doppelgrau/AGO_PoE-Switch/README.md

# AGO_PoE-Switch

A simple ethernet switch, four ports with passive PoE, one without.
Input protected against reverse polarity and over voltage (>15V)
