doppelgrau/AGO_PoE-Switch/Case/stl/Power-Case_Bottom.stl

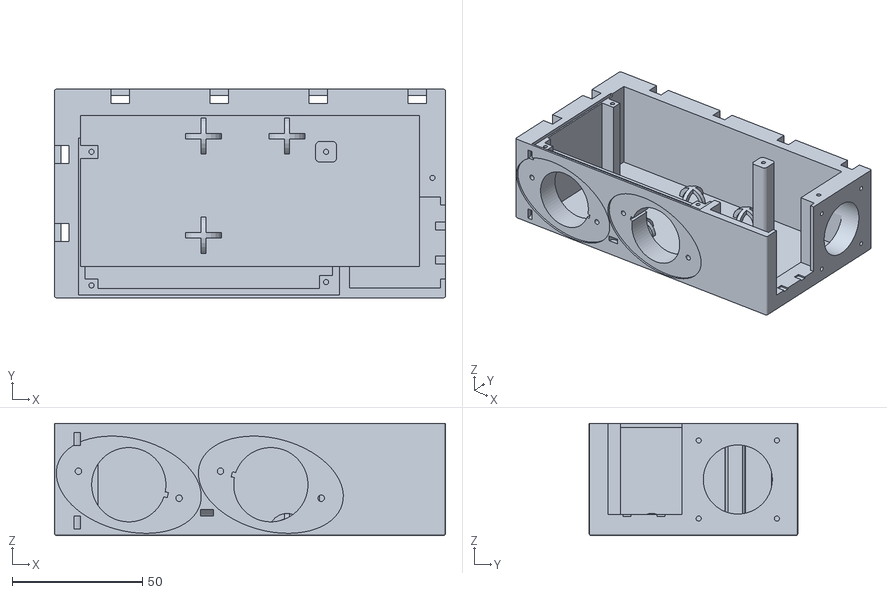
[picture p1: CAD file, 2021-09-09]
Case/stl/Power-Case_Bottom.stl
150.0 x 80.0 x 43.0
