doppelgrau/AGO_PoE-Switch/Case/stl/Power-Case_Top_Transparent.stl

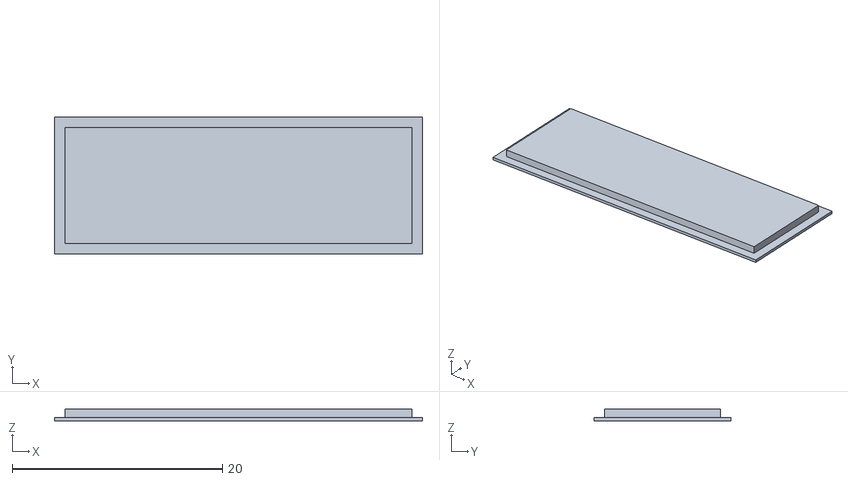
[picture p2: CAD file, 2021-09-09]
Case/stl/Power-Case_Top_Transparent.stl
35.0 x 13.0 x 1.10
