doppelgrau/AGO_PoE-Switch/PCB/Platine-PoE-Switch.pdf

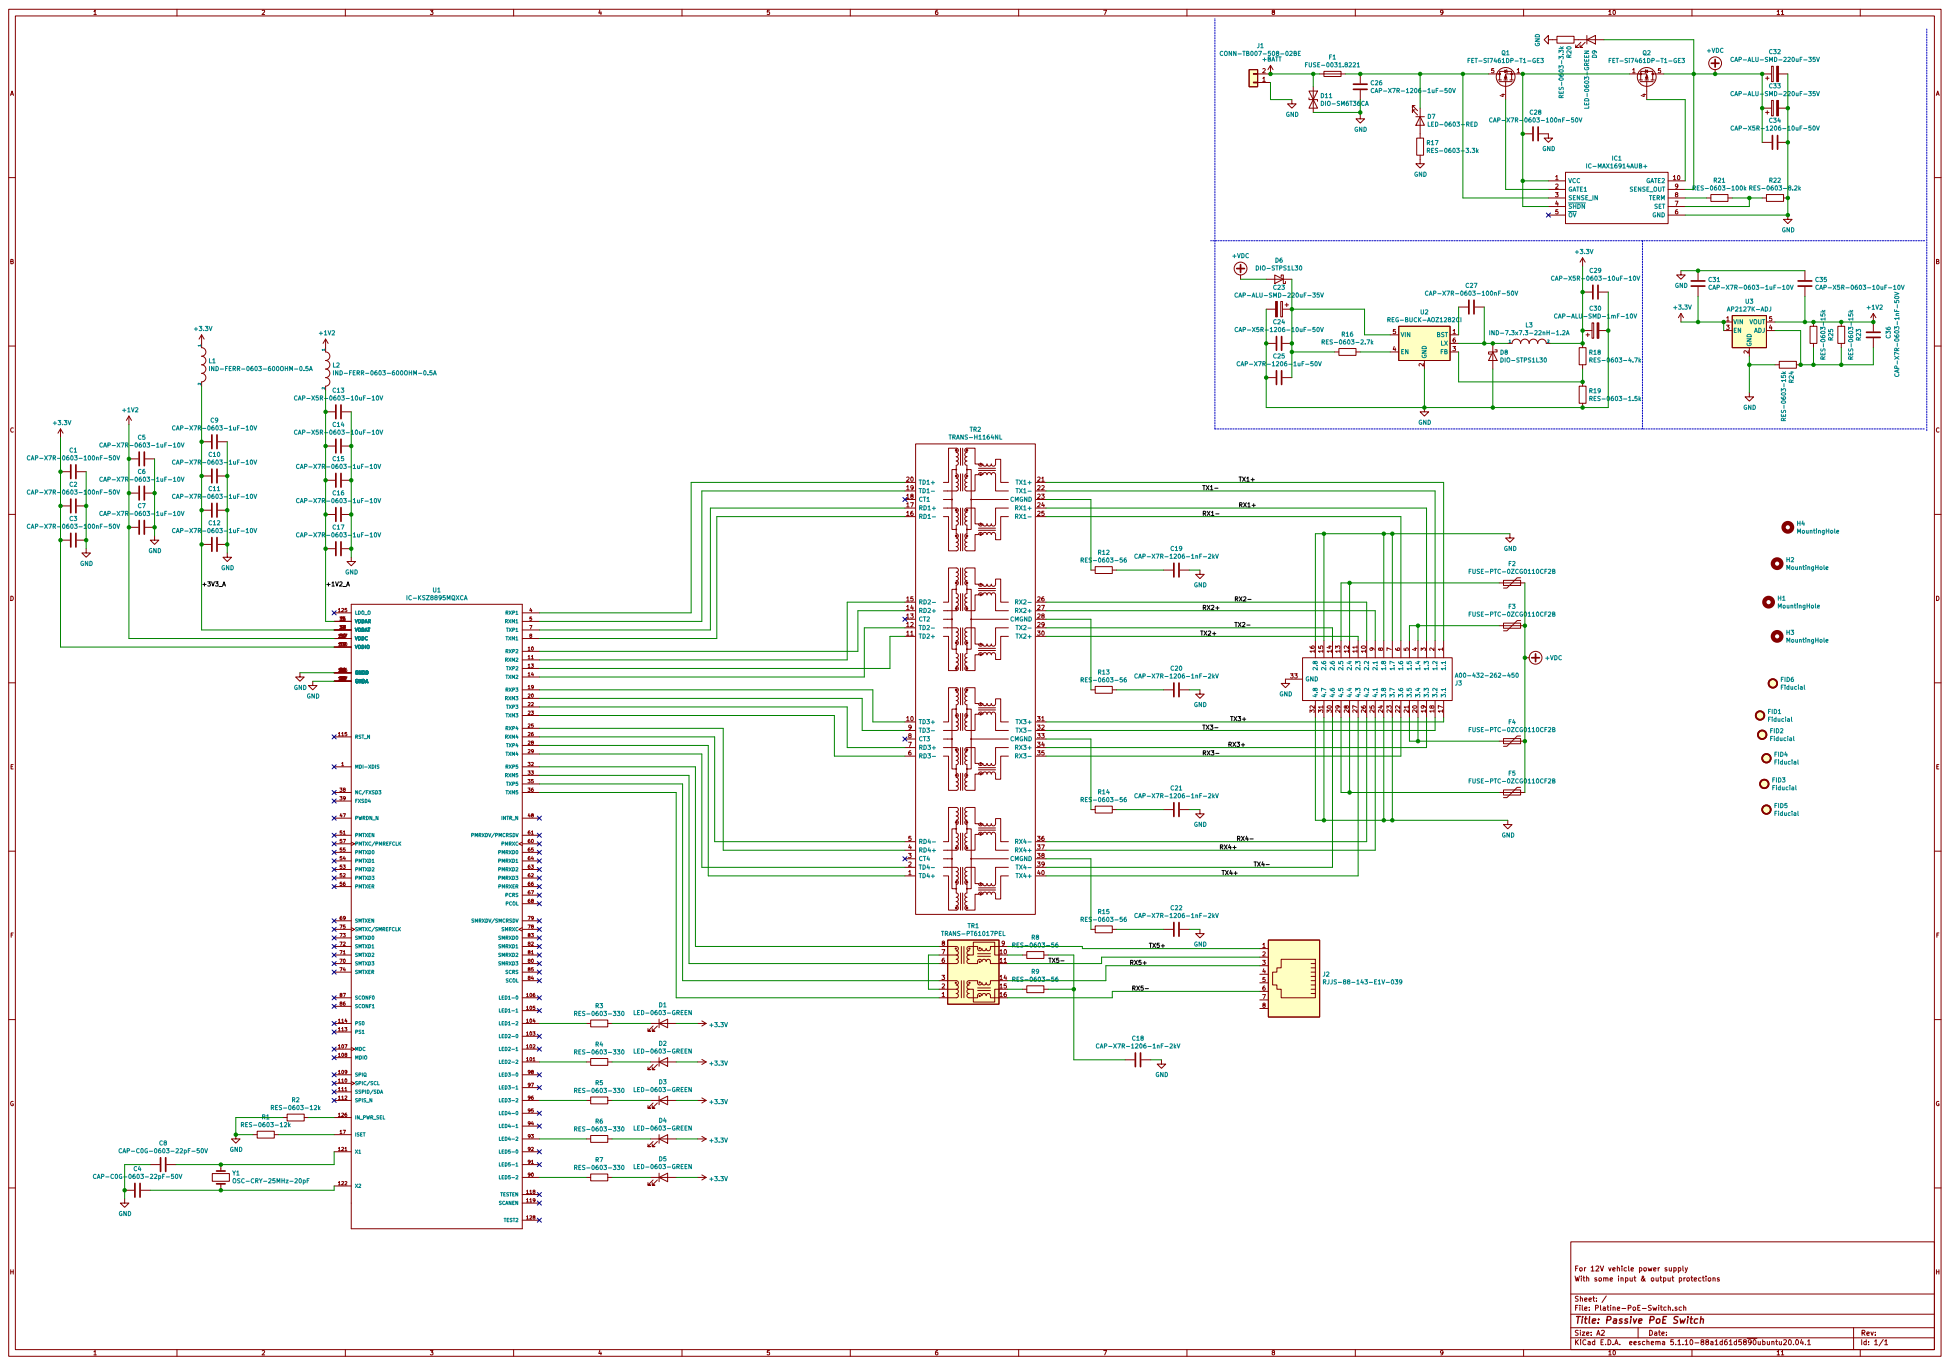
[picture p3: page 1]

IND-FERR-0603-600OHM-0.5A C9 CAP-X7R-0603-1uF-10V C10 CAP-X7R-0603-1uF-10V C11 CAP-X7R-0603-1uF-10V C12 CAP-X7R-0603-1uF-10V GND

C1 CAP-X7R-0603-100nF-50V C2 CAP-X7R-0603-100nF-50V C3 CAP-X7R-0603-100nF-50V GND

For 12V vehicle power supply R1 RES-0603-12k

File: Platine-PoE-Switch.sch Sheet: / With some input & output protections

Id: 1/1 Title: Passive PoE Switch
