doppelgrau/AGO_PoE-Switch/PCB/Platine-PoE-Switch.kicad_pcb

## KiCad design PCB/Platine-PoE-Switch.kicad_pcb (2021-09-09)

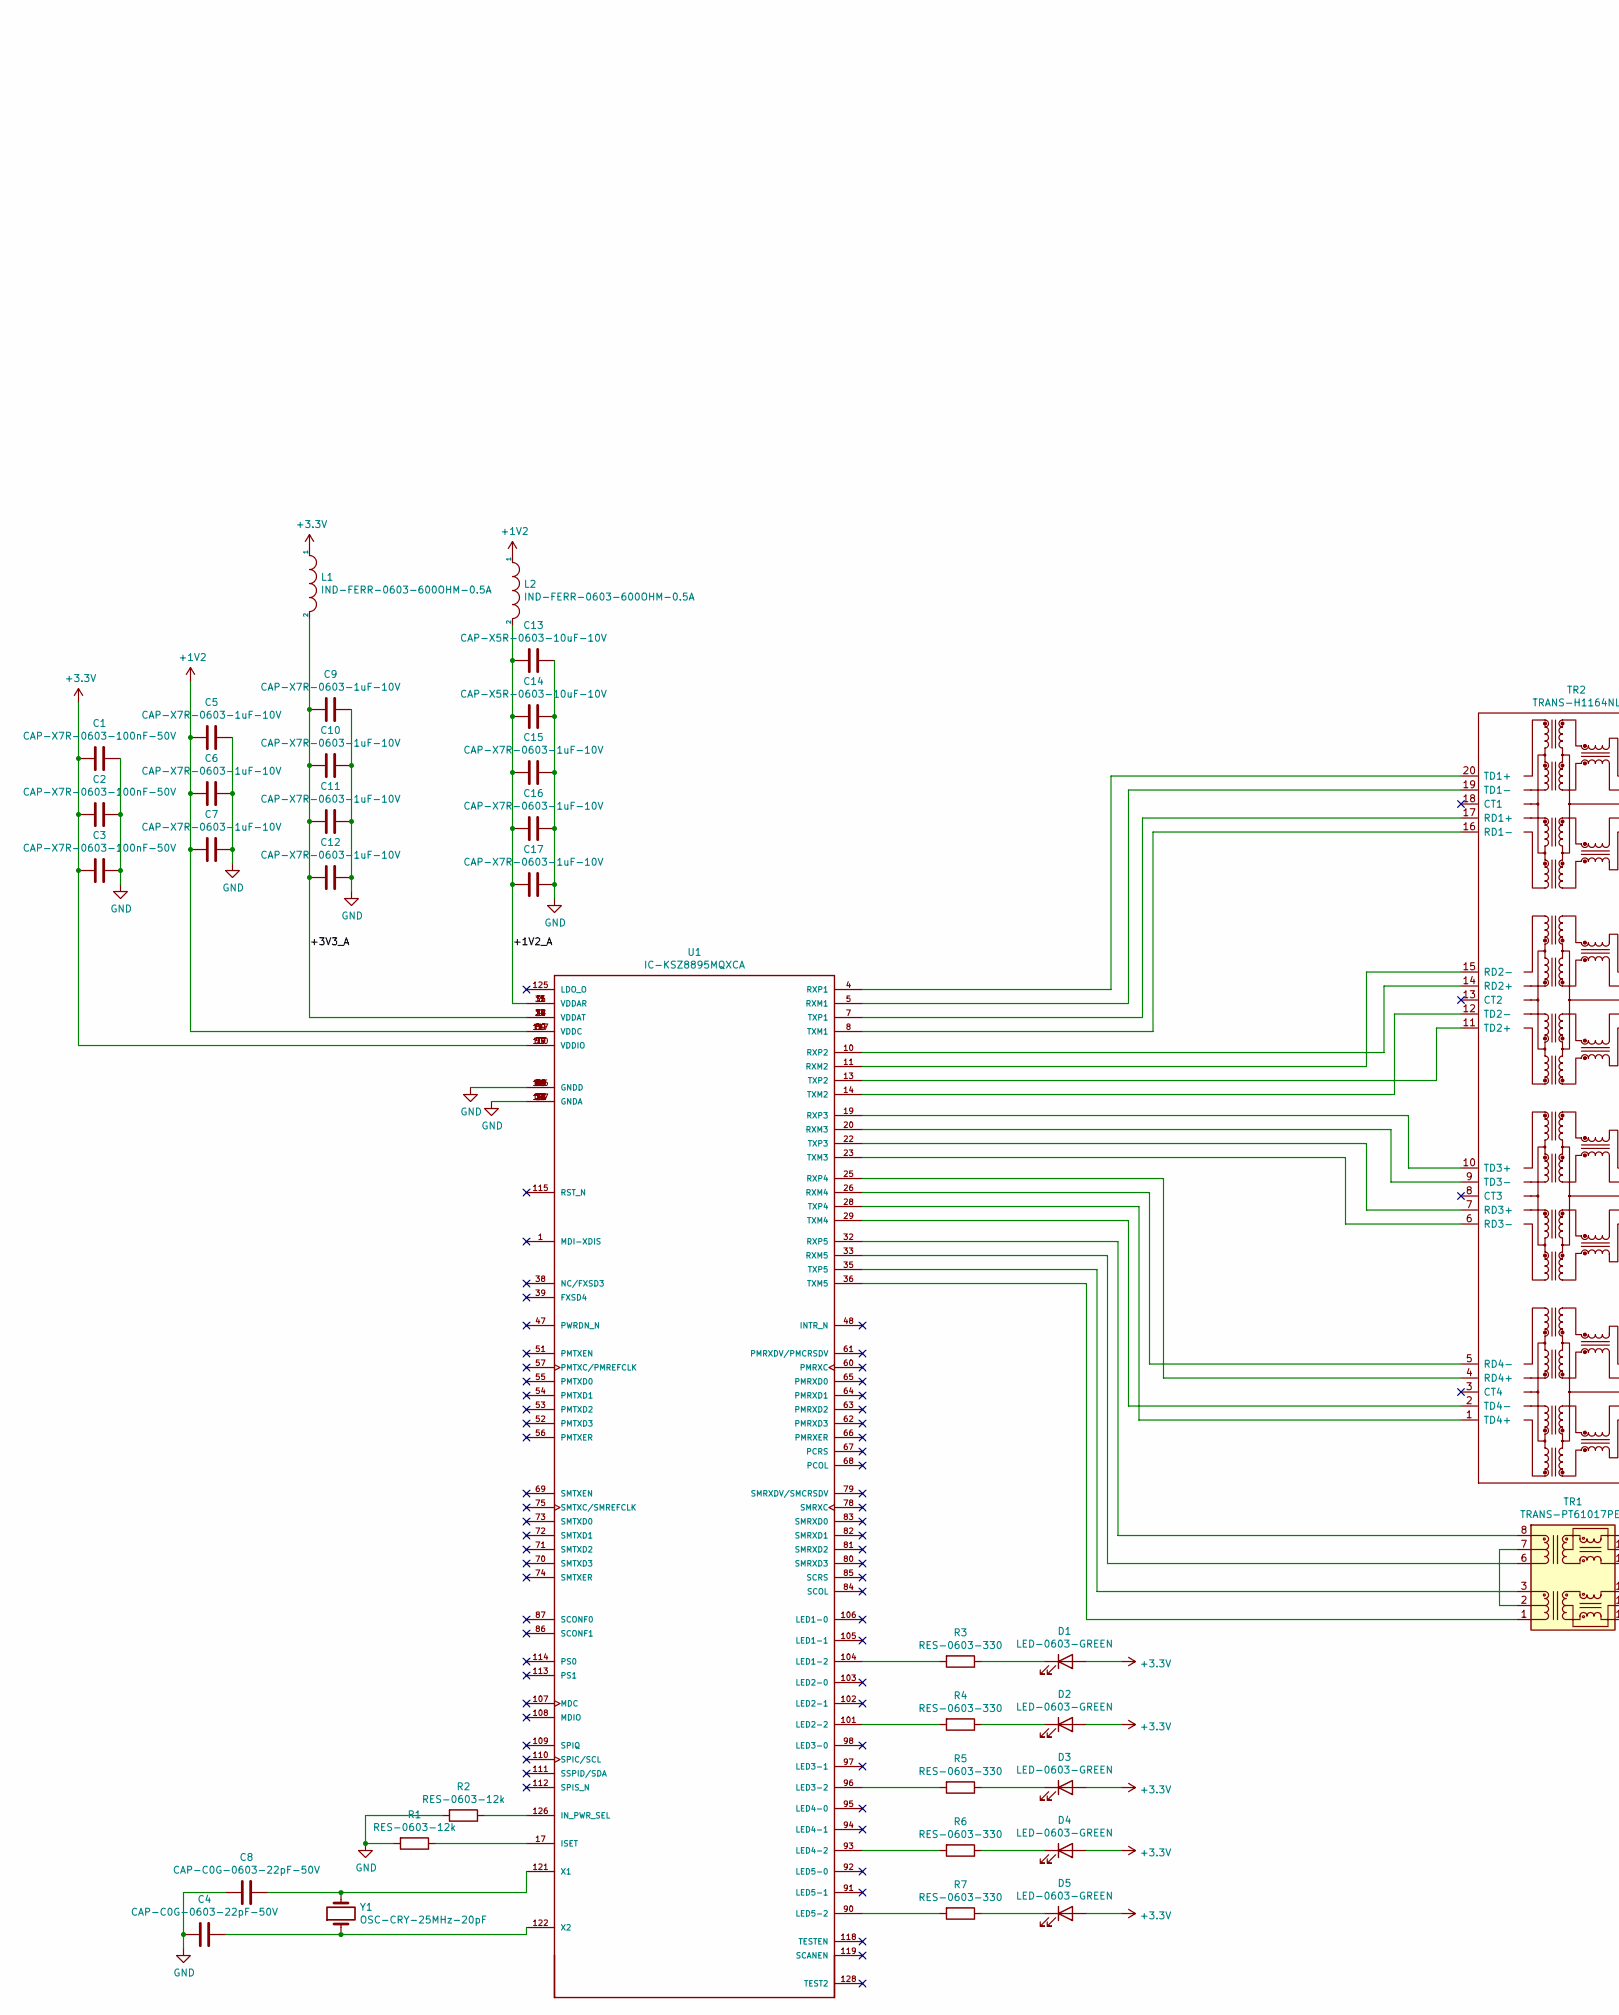
[picture p4: schematic Platine-PoE-Switch.sch, Passive PoE Switch, part in row 1, column 1]

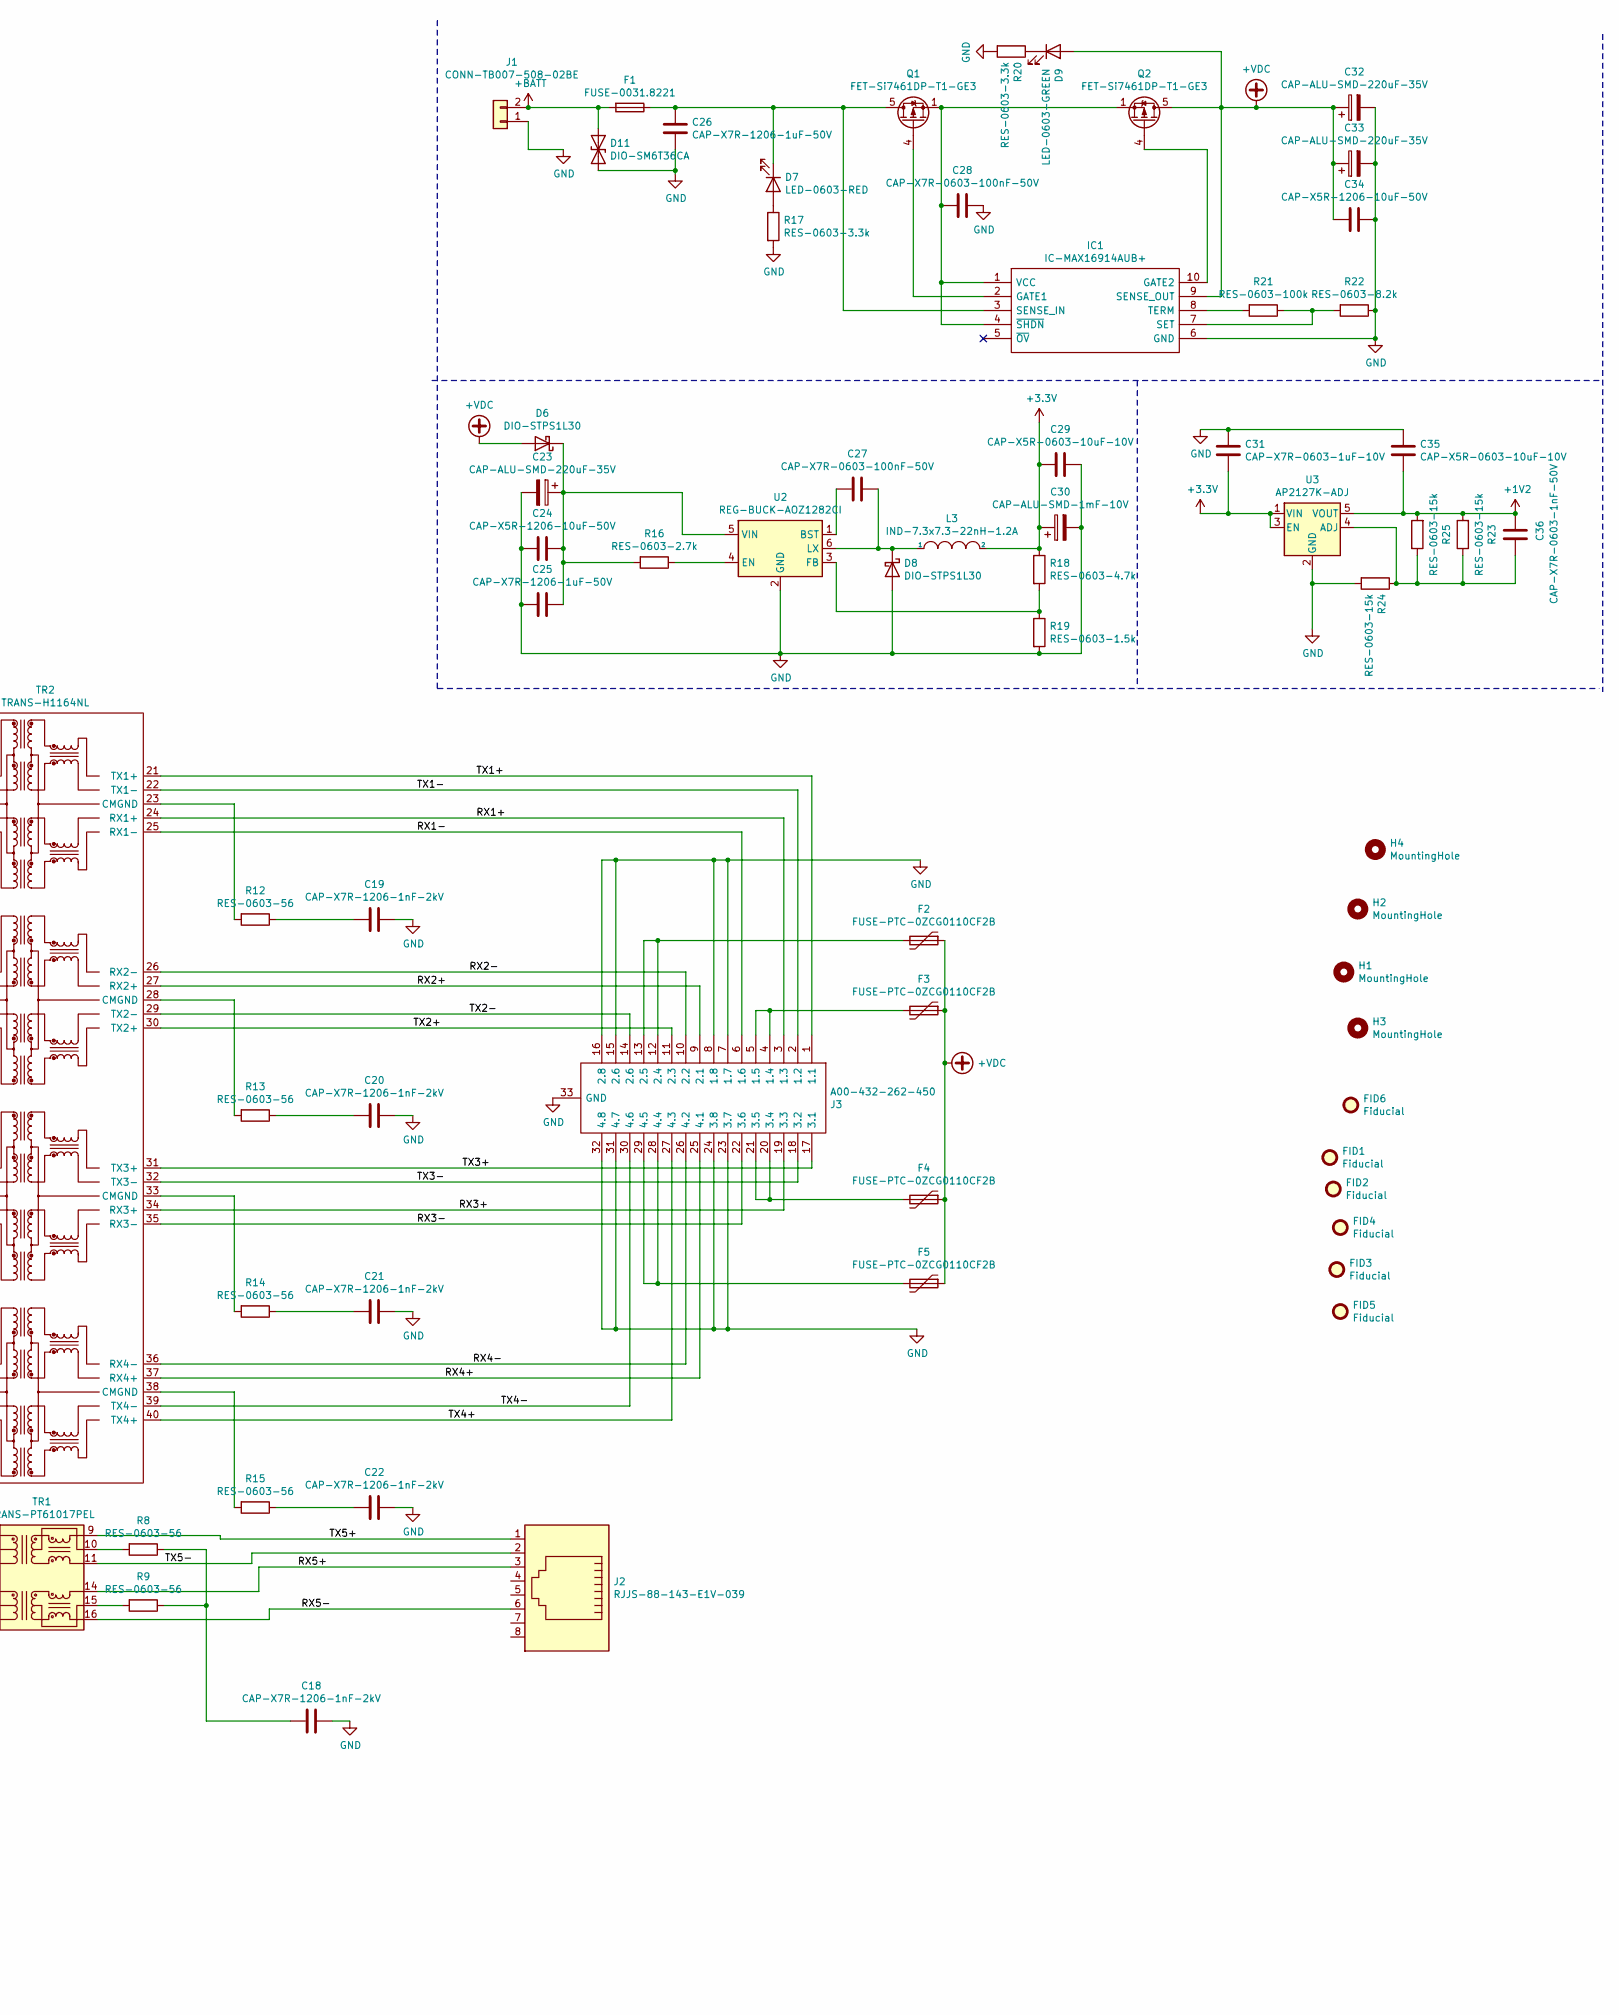
[picture p5: schematic Platine-PoE-Switch.sch, Passive PoE Switch, part in row 1, column 2]

Parts:
C1, C2, C3, C27, C28: CAP-X7R-0603-100nF-50V; C_0603_1608Metric
C4, C8: CAP-C0G-0603-22pF-50V; C_0603_1608Metric
C5, C6, C7, C9, C10, C11, C12, C15, C16, C17, C31: CAP-X7R-0603-1uF-10V; C_0603_1608Metric
C13, C14, C29, C35: CAP-X5R-0603-10uF-10V; C_0603_1608Metric
C18, C19, C20, C21, C22: CAP-X7R-1206-1nF-2kV; C_1206_3216Metric
C23, C32, C33: CAP-ALU-SMD-220uF-35V; CP_Elec_10x10
C24, C34: CAP-X5R-1206-10uF-50V; C_1206_3216Metric
C25, C26: CAP-X7R-1206-1uF-50V; C_1206_3216Metric
C30: CAP-ALU-SMD-1mF-10V; CP_Elec_10x10
C36: CAP-X7R-0603-1nF-50V; C_0603_1608Metric
D1, D2, D3, D4, D5, D9: LED-0603-GREEN; LED_0603_1608Metric
D6, D8: DIO-STPS1L30; D_SMA
D7: LED-0603-RED; LED_0603_1608Metric
D11: DIO-SM6T36CA; D_SMB
F1: FUSE-0031.8221; Fuseholder_Cylinder-5x20mm_Schurter_SMD_0031.8221
F2, F3, F4, F5: FUSE-PTC-0ZCG0110CF2B; Fuse_1812_4532Metric
FID1, FID2, FID3, FID4, FID5, FID6: Fiducial; Fiducial_1mm_Mask2mm
H1, H2, H3, H4: MountingHole; MountingHole_3.2mm_M3
IC1: IC-MAX16914AUB+; SOP50P490X110-10N; Manufacturer_Part_Number MAX16914AUB+
J1: CONN-TB007-508-02BE; TerminalBlock_Phoenix_MKDS-1,5-2-5.08_1x02_P5.08mm_Horizont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
J2: RJJS-88-143-E1V-039
J3: A00-432-262-450; A00432262450; Mouser Part Number 587-A00-432-262-450
L1, L2: IND-FERR-0603-600OHM-0.5A; L_0603_1608Metric
L3: IND-7.3x7.3-22nH-1.2A; DE0703-22
Q1, Q2: FET-Si7461DP-T1-GE3; PowerPAK_SO-8_Single
R1, R2: RES-0603-12k; R_0603_1608Metric
R3, R4, R5, R6, R7: RES-0603-330; R_0603_1608Metric
R8, R9, R12, R13, R14, R15: RES-0603-56; R_0603_1608Metric
R16: RES-0603-2.7k; R_0603_1608Metric
R17, R20: RES-0603-3.3k; R_0603_1608Metric
R18: RES-0603-4.7k; R_0603_1608Metric
R19: RES-0603-1.5k; R_0603_1608Metric
R21: RES-0603-100k; R_0603_1608Metric
R22: RES-0603-8.2k; R_0603_1608Metric
R23, R24, R25: RES-0603-15k; R_0603_1608Metric
TR1: TRANS-PT61017PEL; Transformer_Ethernet_Bourns_PT61017PEL
TR2: TRANS-H1164NL; H1164NL
U1: IC-KSZ8895MQXCA; PQFP-128_14x20mm_P0.5mm
U2: REG-BUCK-AOZ1282CI; SOT-23-6
U3: AP2127K-ADJ; SOT-23-5
Y1: OSC-CRY-25MHz-20pF; Crystal_SMD_HC49-SD

Connections:
+1V2: C5.2, C6.2, C7.2, C35.2, C36.1, L2.1, R23.2, R25.2, U1.50 (VDDC), U1.89 (VDDC), U1.117 (VDDC), U3.5 (VOUT)
+3V3: C1.2, C2.2, C3.2, C29.2, C30.1, C31.2, D1.2 (A), D2.2 (A), D3.2 (A), D4.2 (A), D5.2 (A), L1.1, L3.2, R18.1, U1.59 (VDDIO), U1.77 (VDDIO), U1.100 (VDDIO), U3.1 (VIN), U3.3 (EN)
+BATT: D11.1 (A1), F1.2, J1.2
+VDC: C32.1, C33.1, C34.1, D6.2 (A), D9.2 (A), F2.1, F3.1, F4.1, F5.1, IC1.9 (SENSE_OUT), Q2.5 (D)
/+1V2_A: C13.2, C14.2, C15.2, C16.2, C17.2, L2.2, U1.3 (VDDAR), U1.15 (VDDAR), U1.31 (VDDAR)
/+3V3_A: C9.2, C10.2, C11.2, C12.2, L1.2, U1.9 (VDDAT), U1.18 (VDDAT), U1.24 (VDDAT), U1.37 (VDDAT)
/RX1+: J3.3 (1.3), TR2.24 (RX1+)
/RX1-: J3.6 (1.6), TR2.25 (RX1-)
/RX2+: J3.9 (2.1), TR2.27 (RX2+)
/RX2-: J3.10 (2.2), TR2.26 (RX2-)
/RX3+: J3.19 (3.3), TR2.34 (RX3+)
/RX3-: J3.22 (3.6), TR2.35 (RX3-)
/RX4+: J3.25 (4.1), TR2.37 (RX4+)
/RX4-: J3.26 (4.2), TR2.36 (RX4-)
/RX5+: J2.3, TR1.14 (TX-)
/RX5-: J2.6, TR1.16 (TX+)
/TX1+: J3.1 (1.1), TR2.21 (TX1+)
/TX1-: J3.2 (1.2), TR2.22 (TX1-)
/TX2+: J3.11 (2.3), TR2.30 (TX2+)
/TX2-: J3.14 (2.6), TR2.29 (TX2-)
/TX3+: J3.17 (3.1), TR2.31 (TX3+)
/TX3-: J3.18 (3.2), TR2.32 (TX3-)
/TX4+: J3.27 (4.3), TR2.40 (TX4+)
/TX4-: J3.30 (4.6), TR2.39 (TX4-)
/TX5+: J2.1, TR1.9 (RX-)
/TX5-: J2.2, TR1.11 (RX+)
GND: C1.1, C2.1, C3.1, C4.2, C5.1, C6.1, C7.1, C8.2, C9.1, C10.1, C11.1, C12.1, C13.1, C14.1, C15.1, C16.1, C17.1, C18.1, C19.1, C20.1, C21.1, C22.1, C23.2, C24.2, C25.2, C26.2, C28.1, C29.1, C30.2, C31.1, C32.2, C33.2, C34.2, C35.1, D8.2 (A), D11.2 (A2), IC1.6 (GND), J1.1, J3.7 (1.7), J3.8 (1.8), J3.15 (2.6), J3.16 (2.8), J3.23 (3.7), J3.24 (3.8), J3.31 (4.7), J3.32 (4.8), J3.33 (GND), J3.34, J3.35, J3.36, J3.37, R1.2, R2.2, R17.2, R19.2, R20.2, R22.1, R24.2, U1.2 (GNDA), U1.6 (GNDA), U1.12 (GNDA), U1.16 (GNDA), U1.21 (GNDA), U1.27 (GNDA), U1.30 (GNDA), U1.34 (GNDA), U1.49 (GNDD), U1.58 (GNDD), U1.76 (GNDD), U1.88 (GNDD), U1.99 (GNDD), U1.116 (GNDD), U1.127 (GNDA), U2.2 (GND), U3.2 (GND)
unnamed: C4.1, U1.122 (X2), Y1.1
unnamed: C8.1, U1.121 (X1), Y1.2
unnamed: C18.2, R8.1, R9.1
unnamed: C19.2, R12.1
unnamed: C20.2, R13.1
unnamed: C21.2, R14.1
unnamed: C22.2, R15.1
unnamed: C23.1, C24.1, C25.1, D6.1 (K), R16.2, U2.5 (VIN)
unnamed: C26.1, D7.1 (K), F1.1, IC1.3 (SENSE_IN), Q1.5 (D)
unnamed: C27.1, D8.1 (K), L3.1, U2.6 (LX)
unnamed: C27.2, U2.1 (BST)
unnamed: C28.2, IC1.1 (VCC), IC1.4 (~SHDN), Q1.1 (S), Q1.2 (S), Q1.3 (S), Q2.1 (S), Q2.2 (S), Q2.3 (S)
unnamed: C36.2, R23.1, R24.1, R25.1, U3.4 (ADJ)
unnamed: D1.1 (K), R3.1
unnamed: D2.1 (K), R4.1
unnamed: D3.1 (K), R5.1
unnamed: D4.1 (K), R6.1
unnamed: D5.1 (K), R7.1
unnamed: D7.2 (A), R17.1
unnamed: D9.1 (K), R20.1
unnamed: F2.2, J3.12 (2.4), J3.13 (2.5)
unnamed: F3.2, J3.4 (1.4), J3.5 (1.5)
unnamed: F4.2, J3.20 (3.4), J3.21 (3.5)
unnamed: F5.2, J3.28 (4.4), J3.29 (4.5)
unnamed: IC1.2 (GATE1), Q1.4 (G)
unnamed: IC1.7 (SET), R21.1, R22.2
unnamed: IC1.8 (TERM), R21.2
unnamed: IC1.10 (GATE2), Q2.4 (G)
unnamed: R1.1, U1.17 (ISET)
unnamed: R2.1, U1.126 (IN_PWR_SEL)
unnamed: R3.2, U1.104 (LED1-2)
unnamed: R4.2, U1.101 (LED2-2)
unnamed: R5.2, U1.96 (LED3-2)
unnamed: R6.2, U1.93 (LED4-2)
unnamed: R7.2, U1.90 (LED5-2)
unnamed: R8.2, TR1.10 (C_RX)
unnamed: R9.2, TR1.15 (C_TX)
unnamed: R12.2, TR2.23 (CMGND)
unnamed: R13.2, TR2.28 (CMGND)
unnamed: R14.2, TR2.33 (CMGND)
unnamed: R15.2, TR2.38 (CMGND)
unnamed: R16.1, U2.4 (EN)
unnamed: R18.2, R19.1, U2.3 (FB)
unnamed: TR1.1 (TD+), U1.36 (TXM5)
unnamed: TR1.2 (C_TD), TR1.7 (C_RD)
unnamed: TR1.3 (TD-), U1.35 (TXP5)
unnamed: TR1.6 (RD+), U1.33 (RXM5)
unnamed: TR1.8 (RD-), U1.32 (RXP5)
unnamed: TR2.1 (TD4+), U1.28 (TXP4)
unnamed: TR2.2 (TD4-), U1.29 (TXM4)
unnamed: TR2.4 (RD4+), U1.25 (RXP4)
unnamed: TR2.5 (RD4-), U1.26 (RXM4)
unnamed: TR2.6 (RD3-), U1.23 (TXM3)
unnamed: TR2.7 (RD3+), U1.22 (TXP3)
unnamed: TR2.9 (TD3-), U1.20 (RXM3)
unnamed: TR2.10 (TD3+), U1.19 (RXP3)
unnamed: TR2.11 (TD2+), U1.13 (TXP2)
unnamed: TR2.12 (TD2-), U1.14 (TXM2)
unnamed: TR2.14 (RD2+), U1.10 (RXP2)
unnamed: TR2.15 (RD2-), U1.11 (RXM2)
unnamed: TR2.16 (RD1-), U1.8 (TXM1)
unnamed: TR2.17 (RD1+), U1.7 (TXP1)
unnamed: TR2.19 (TD1-), U1.5 (RXM1)
unnamed: TR2.20 (TD1+), U1.4 (RXP1)

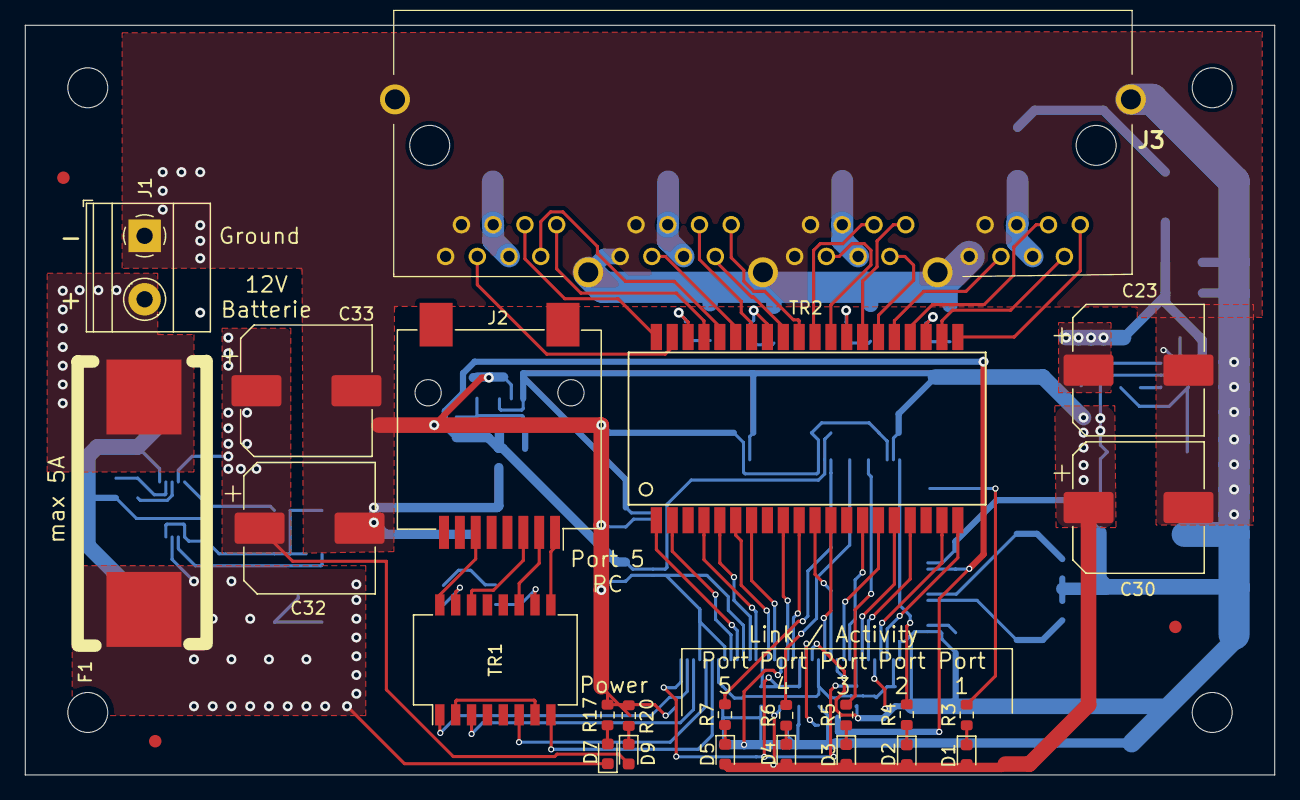
[picture p6: board Platine-PoE-Switch.kicad_pcb from above]

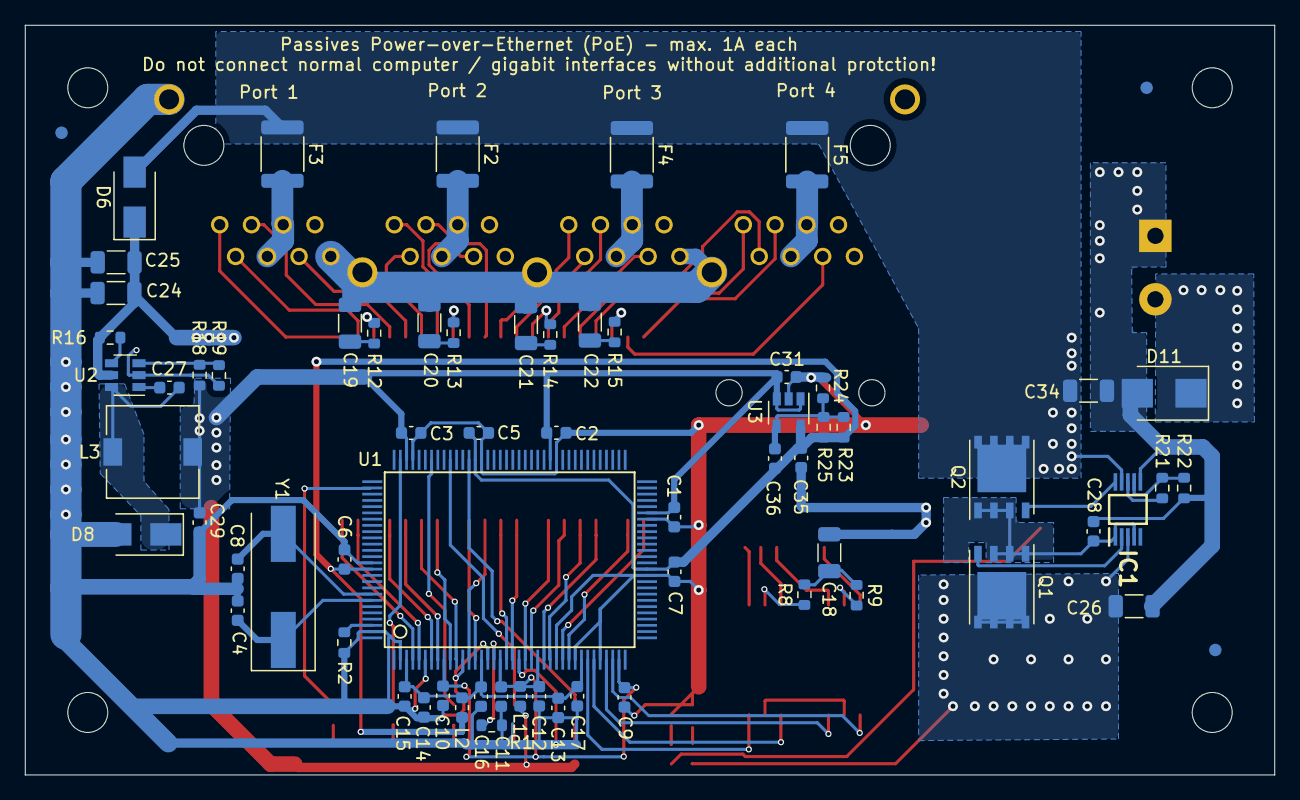
[picture p7: board Platine-PoE-Switch.kicad_pcb from below]

Board: 2 copper layers, 100.0 x 60.0 mm, 99 parts (68 on the bottom side), 91 nets.
